alphane-ai/welded-modular-chassis-cad/research/README.md

# 研究记录的范围

本目录保存当前名义尺寸、2026-11-05审核待办及槽24修订核验摘录。原始CAD与PDF只放在生产目录；这里不复制一套旧模型。

| 文件 | 含义 |
| --- | --- |
| [dimensions-current.json](dimensions-current.json) | 当前槽24及箱体、侧板、后孔的名义尺寸汇总 |
| [audit-findings.json](audit-findings.json) | 18项历史审核问题，含后续槽24修订说明；不表示已全部解决 |
| [evidence/slot24-verification.log](evidence/slot24-verification.log) | 历史SOLIDWORKS修订、干涉、保存和重开结果摘录 |

2026-11-07本次上传重新核对的是15个交付文件的数量、内容哈希及仓库资料。没有重新运行全部CAD检查，没有执行实物试制。

图纸原说明及日志中的旧日期、旧侧盖板名称、方案图“尚未修改”等文字保留其记录语境。当前采用的槽宽为24 mm，侧板前卡耳槽仍为18 × 5 mm，背板2 × 24 mm避让保留。

日志只摘录核验结果，去掉电脑绝对路径，并合并重复的相同行；不上传账号凭据、对话原文、临时备份和非生产历史文件。
