alphane-ai/welded-modular-chassis-cad/docs/dimensions-and-interfaces.md

# 名义尺寸与接口

下表汇总当前焊接版的名义值，用于理解设计和检查关联修改。制造尺寸、公差和局部轮廓应同时查阅CAD及工程图。历史审核发现的图模差异见[制造与核验状态](manufacturing-and-verification.md)。

## 坐标与箱体尺寸

模型以X表示箱体宽向，Y表示高度，Z表示前后方向：X0为箱体左侧基准位置，Y0为底面，后外面Z0，前外面Z=-308。侧板孔阵列另以U从前端起算。

| 项目 | 数值 mm | 范围与解释 |
| --- | --- | --- |
| 箱体基体长×宽×高 | 308 × 71.2 × 189 | 不含外伸件 |
| 板厚名义值 | 1.2 | 厚度验收与一般±0.5存在待澄清项 |
| 内部下 / 上平面 | Y1.2 / Y187.8 | 平板内部净高186.6 |
| 回折处最小内部净高 | 184.2 | 按现有说明及历史核验 |
| 四条回折宽 / 有效长 | 8 / 278 | 工艺展开需试折确认 |
| 含侧板基体宽 | 72.4 | 71.2 + 1.2，不含外伸安装件 |
| 含侧板全部已建零件包络 | 长319.3 × 宽84.9 × 高189 | 历史核验；含外伸件，不含未建螺钉 |
| 相同双箱相对平移 | X71.2 | 使用同一套单箱零件 |

## 前插榫槽24修订

| 特征 | 下片 | 上片 |
| --- | ---: | ---: |
| 片中心Y | 50.5 | 138.5 |
| 宽头下边Y | 34.5 | 122.5 |
| 宽头上边Y | 66.5 | 154.5 |
| 槽下边Y | 38.5 | 126.5 |
| 槽上边Y | 62.5 | 150.5 |
| 窄舌下边Y | 42.5 | 130.5 |
| 窄舌上边Y | 58.5 | 146.5 |

| 共用尺寸 | 数值 mm |
| --- | ---: |
| 头宽 / 槽宽 / 上下边栏各 | 32 / 24 / 4 |
| 舌宽 / 舌端上下角半径 | 16 / R2 |
| 槽短边名义值 | 4.5 |
| 头宽净距 / 窄舌净距 / 槽净距 | 56 / 72 / 64 |
| 头部到上下内部平面各 | 33.3 |
| 窄舌到上下内部平面各 | 41.3 |
| 槽到上下内部平面各 | 37.3 |
| 上下片中心距 | 88 |
| 每片点焊X坐标 / 同排点距 | 18、47 / 29 |

两条竖向尺寸链应满足：

```text
宽头：33.3 + 32 + 56 + 32 + 33.3 = 186.6
槽口：37.3 + 24 + 64 + 24 + 37.3 = 186.6
片内：4 + 24 + 4 = 32
```

焊接版前插榫与前面板的原安装铆孔取消为加工孔，相关草图以构造几何或抑制特征保留。不要把点焊定位十字当成钻孔。

## 后部组合孔与挡片

| 项目 | 当前值 |
| --- | --- |
| 后挡片外形 | 24.5 × 8 × 1.2 mm |
| 螺纹 | M3×0.5-6H，模型底孔Ø2.5 |
| 挡片外伸孔X / 背板孔X | -6 / 65.2 mm |
| 下孔Y / 上孔Y / 中心距 | 20.5 / 163.5 / 143 mm |
| 孔至接缝或侧板内贴合面 | 6 mm |
| 每片两段焊缝 | X3～11，每段长8 mm |
| 下挡片焊缝Y / 上挡片焊缝Y | 16.5、24.5 / 159.5、167.5 mm |

M3接口两层均带螺纹的方案按用户要求保留。独立攻丝相位、夹紧方式、螺钉长度与扭矩尚需确认。

## 侧板与前后安装接口

| 项目 | 当前名义值 |
| --- | --- |
| 覆盖外形 / 名义板厚 | 308 × 189 / 1.2 mm |
| 前卡耳数量 / 槽 / 外高 / 内伸 | 2 / 18 × 5 / 26 / 12 mm |
| 前卡槽中心Y | 50.5、138.5 mm |
| 前18槽配16舌的居中余量 | 上下各1 mm，未计极限公差与涂层 |
| 后一体耳数量 / 折弯角 | 2 / 90° |
| 后耳内R / 外R / 耳高 / 平段 | 1.2 / 2.4 / 20 / 10.8 mm |
| 后耳两侧释放槽宽 | 1.2 mm |
| 后耳M3孔 | X65.2，Y20.5、163.5 mm |
| 侧盖内贴合面 | X71.2 mm；双箱最外侧X142.4 mm |
| 背板局部避让 | X69.2～71.2；Y8.5～32.5和151.5～175.5 mm |
| 避让缺口 | 两处2 × 24 mm，内角R0.5，直段23 mm |

侧盖三个外角随箱体R1.7，后下角保留原直角。周边名义贴合不等于已经定义成品最大允许缝隙。

## 侧板X形压印与网孔

| 项目 | 当前值 |
| --- | --- |
| 压印方向 / 深度 | 向箱内 / 1 mm，交叉中心同深1 mm |
| 名义根部宽 / 冠部宽 | 12 / 6 mm |
| 过渡圆角 / 端头 | R2 / R6 |
| 斜筋中心端点1 | (U30,Y26) 到 (U278,Y163) |
| 斜筋中心端点2 | (U30,Y163) 到 (U278,Y26) |
| 无孔横带 | Y84～105，宽21 mm，中线Y94.5 |
| 侧板网孔 | 1522个Ø2，上下各761，节距4 × 4 mm |
| 网孔避让规则 | 孔心到任一斜筋有限中心线段距离小于10 mm的孔取消 |
| 历史记录的筋边到孔边最小名义净距 | 约2.69 mm，考虑R2过渡 |
| 主体上下网孔 | 每面621个Ø2，9列 × 69排，总计1242孔 |
| 主体网孔孔心 | X=19.6+4n，n=0～8；Z=-18-4m，m=0～68 |

所有表中未特别说明的尺寸单位为mm。一般±0.5与未注R0.5沿用用户决定，功能配合、板厚、螺纹及涂后验收的未决事项另行记录，未擅自改成其他公差。
