alphane-ai/welded-modular-chassis-cad/生产图纸 焊接固定/打开与修改说明.md

# 前后安装件焊接版

打开“全焊_相同双箱含侧板_草图可编辑.SLDASM”查看两个相同单体机箱及最外侧盖板装配；侧板前卡槽18配舌宽16、上下各留名义1mm，后耳M3孔同轴、距贴合面6mm，盖板与箱体侧边名义间隙0。已重新打开验证10个组件引用，静态干涉0。也可打开“全焊_相同双箱_草图可编辑.SLDASM”或“全焊_单箱含侧板_草图可编辑.SLDASM”。保留“配套侧板”子目录一起传递。

- 前插榫仍为每片2点电阻点焊、每单箱4点；舌宽16、头宽32、槽24、R2、上下中线Y50.5/138.5；槽上下边栏各4，定位保持原设计。
- 两片后安装挡片改为短段激光搭接焊，上下边各1段长8；各段X3~11，下片Y16.5/24.5，上片Y159.5/167.5。仅焊到本机箱背板，外伸部分及相邻机箱不焊。
- 后挡片24.5x8x1.2保持；原2个Ø2.2铆孔及背板对应4孔取消。挡片M3x0.5-6H保持X=-6，背板组合M3保持X65.2，上下Y20.5/163.5，孔距143。孔距机箱接缝6保持。
- 原后铆孔圆和尺寸改为草图构造几何，仍可编辑；恢复为普通圆后可改回铆接。前安装铆孔仍保留已抑制切除特征。主体30个草图，前插榫7个草图，后挡片2个草图；不是钣金展开工艺树，部分轮廓未全约束。
- 已验证后挡片与背板名义贴合间隙为0、拟定焊缝处下方是实体背板；原组装20纳米显示间隔已移除。
- 单箱、相同双箱、含侧板三套装配重新打开，全部引用本目录，静态实体干涉均0。两个相同单箱相对X平移71.2，两个M3组合孔名义轴线偏差0，侧板后耳M3孔轴对齐。
- 工程图8页，11处原生尺寸无悬空；包含焊缝位置、孔型、公差±0.5、未注R0.5、SPCC t1.2及校平/磨砂/钛灰喷漆要求。逐页渲染检查图文排版。
- 侧板修订X1：308×189×1.2；X形浅压印向箱内深1mm，交叉中心同深1mm，根部名义宽12、冠部宽6、过渡R2、圆头R6。中线Y94.5上下对称，Y84~105保留21mm连续无孔横带。
- 侧板网孔1522个Ø2，方格4×4，上下各761孔；取消孔心至任一斜筋有限中心线段距离小于10的孔。斜筋中心端点为(U30,Y26)-(U278,Y163)、(U30,Y163)-(U278,Y26)，U从前端起算。名义12宽轮廓到孔边至少3，实际R2过渡到孔边最小名义净距约2.69mm。
- 侧盖板15个原生草图；覆盖尺寸、孔径、压印基准面位置、过渡圆角及板厚可在特征树编辑。1522孔共用等径约束；已实测修改孔径、重建、恢复。网孔孔心与压印轮廓尚未完全约束，改变外形或压印尺寸后需复核孔位及避让；不是可直接展开的钣金工艺树。
- 新增“配套侧板/全焊_侧板_X压印深1_尺寸与制造要求.SLDDRW”及同名PDF，7页、46处尺寸无悬空（31处模型关联尺寸、15处二维定位详图尺寸）；涵盖外形、压印、网孔、前后安装件、焊接、公差和表面处理。主体工程图8页已更新背板局部避让，合计15页。
- B1一体侧板总成、单箱含侧板、双箱含侧板分别重建检查，引用全部位于本目录，静态干涉均0。周边贴合面仍为X71.2（双箱全局X142.4），前卡槽和后M3位置保持原设计。
- 焊缝/熔核实体和螺钉未建模，未进行实物承载验证、完整公差叠加或X1侧板的装配路径扫描；名义静态无干涉不代替制造验收。侧板前L卡耳点焊按侧板工程图，同材同厚试焊确认；侧板后M3耳与盖板同料一体折弯，不焊接。
- 激光焊有效焊缝厚度、熔核尺寸、焊接参数必须由加工方同材同厚试焊确认。确保后焊缝熔合至背板、两侧电极可达、无烧穿裂纹；交替短焊、焊后校平，再喷漆并保护M3。
- 原铆接版、螺栓版及前焊后铆版均未覆盖。整理旧窗口时，未保存内容副本在工作目录“前后全焊_核验/未保存窗口副本_…”中。

## B1 侧板后耳一体折弯与边角随形修订

- 侧板后M3安装耳改为盖板同料一体90°折弯，2处；不允许后耳分体焊接。内R1.2、外R2.4，厚1.2，耳高20，平段10.8，M3×0.5-6H，底孔Ø2.5。孔中心X65.2、Y20.5/163.5、中心距143，至侧盖内贴合面X71.2的距离6保持。
- 侧盖板内的原生草图、拉伸、切除、圆角及2处原生螺纹标注保留；是一体连续实体。折弯两侧工艺释放槽宽1.2、至Z−2.4；实际展开、折弯补偿和回弹需同材同厚试折确认。当前仍是可编辑实体特征树，不是自动钣金展开树。
- 用户确认允许背板上下局部避让。背板右缘新增2处2×24缺口，X69.2~71.2；Y8.5~32.5及151.5~175.5，内角R0.5。M3轴线及机箱本体后部焊接组合挡片不变。
- 对照箱体实际折弯轮廓，侧盖板前上、前下、后上三角随箱体外R1.7；箱体对应内圆角R0.5。后下角按原箱体直角保留。覆盖包络308×189保持。
- 侧板总成只含一体盖板1件及前L卡耳2件；原分体后耳已移出生产目录备份。侧板、单箱含侧板、相同双箱含侧板分别为3、10、17个递归组件节点；重建后静态干涉0。
- 单箱含侧板三维装配的“注解”树保存M01外形、M02后M3及折弯、M03前舌卡槽、M04侧板网孔压印、M05主体顶底网孔、M06后板开口避让六组视图，共27个模型关联参考尺寸；制造仍以工程图标注为准。可在注解树切换视图，防止所有标注同时叠在一起。
- B1主体工程图8页；侧板工程图7页，其中第7页为一体折弯截面与背板避让。原分体后耳焊接说明已移除。保留一般±0.5、M3按6H、未注R0.5，SPCC t1.2，校平/磨砂/钛灰喷漆。

## C1 前插榫槽24修订（2026-11-05）

- 按批准方案，将两片前插榫自身槽净宽由22改为24，每槽上下边各向外扩1，槽中线不变。边栏各由5改为4；两槽净距由66改为64，槽至上下内部平面距离各由38.3改为37.3。
- 上槽Y126.5~150.5；下槽Y38.5~62.5；头宽32、舌宽16、舌端R2、宽头间距56、窄舌间距72、中心距88及焊点保持。侧板前卡耳的18x5槽保持，背板两处2x24折弯避让保持。
- 共用前插榫零件保留7个原生草图；单箱、单箱含侧板、相同双箱、相同双箱含侧板4套装配已更新。实体检查与特征错误均0，4套装配静态干涉均0。
- 主体工程图第6、7页对应槽宽、边栏和名义间隙说明同步为24、4、4，公差继续为±0.5。其余历史审核事项不因本次槽宽修订自动视为解决。
