alphane-ai/welded-modular-chassis-cad/生产图纸 焊接固定/全焊_单箱_草图可编辑.SLDASM

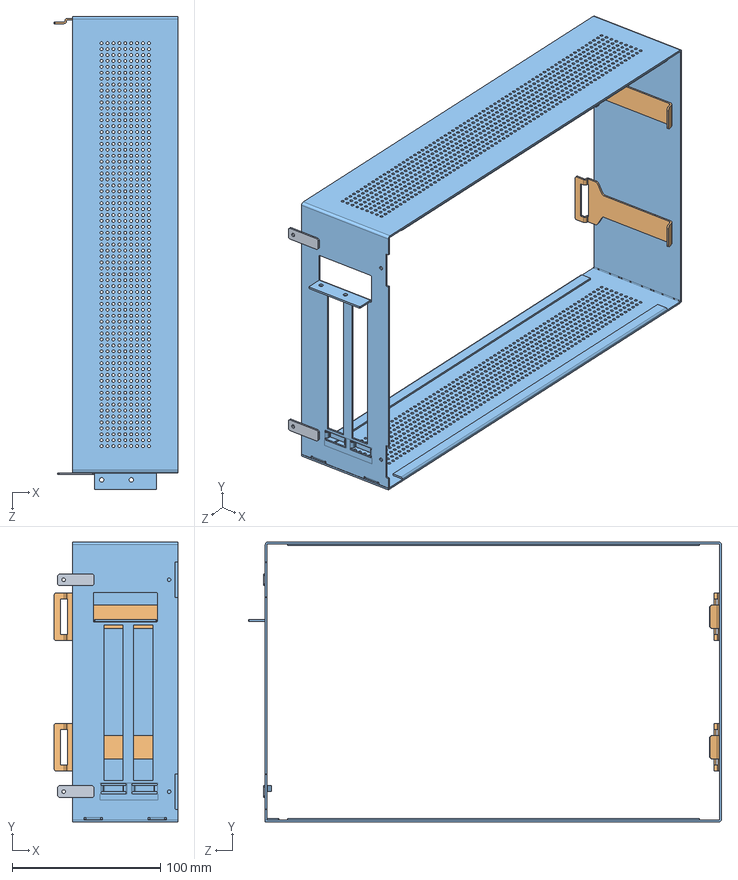
[picture p4: CAD file, 2026-11-07]
生产图纸 焊接固定/全焊_单箱_草图可编辑.SLDASM
83.7 x 189.0 x 319.3 mm
全焊_主体_草图可编辑
全焊_前插榫_舌16_R2_草图可编辑 x 2
全焊_后安装挡片_M3_草图可编辑 x 2
