alphane-ai/welded-modular-chassis-cad/生产图纸 焊接固定/配套侧板/全焊_侧板总成_草图可编辑.SLDASM

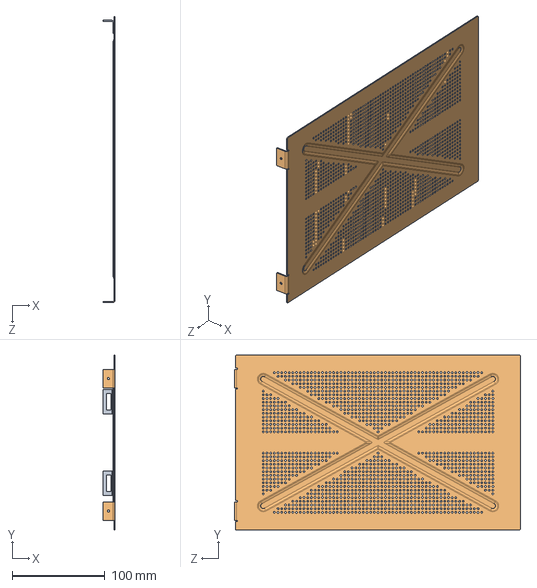
[picture p5: CAD file, 2026-11-07]
生产图纸 焊接固定/配套侧板/全焊_侧板总成_草图可编辑.SLDASM
13.2 x 189.0 x 309.2 mm
全焊配套_侧盖板_草图可编辑
全焊配套_前卡耳_内伸12_槽18乘5_草图可编辑 x 2
