alphane-ai/welded-modular-chassis-cad/生产图纸 焊接固定/全焊_单箱含侧板_草图可编辑.SLDASM

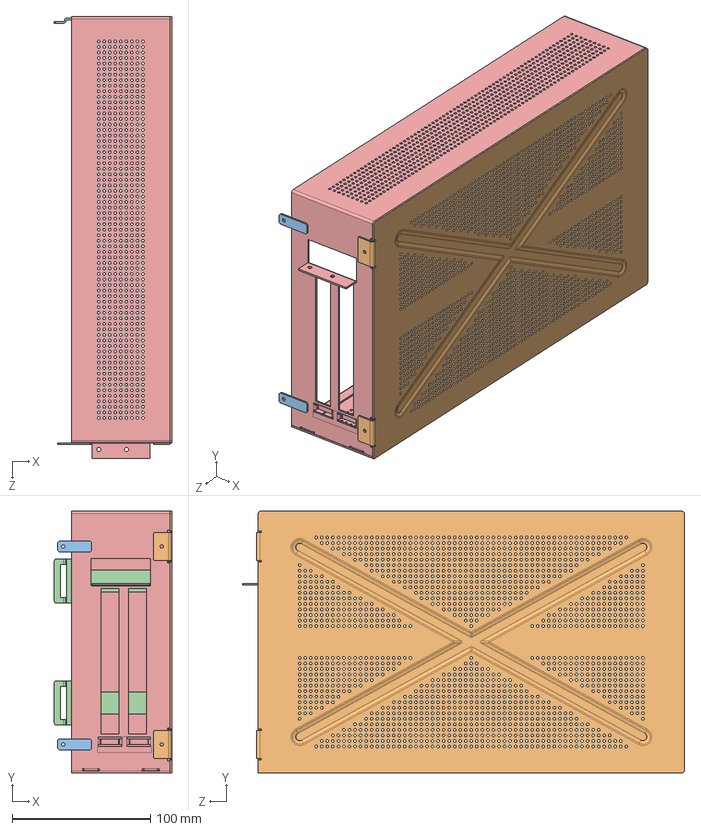
[picture p6: CAD file, 2026-11-07]
生产图纸 焊接固定/全焊_单箱含侧板_草图可编辑.SLDASM
84.9 x 189.0 x 319.3 mm
全焊_主体_草图可编辑
全焊_前插榫_舌16_R2_草图可编辑 x 2
全焊_后安装挡片_M3_草图可编辑 x 2
全焊配套_侧盖板_草图可编辑
全焊配套_前卡耳_内伸12_槽18乘5_草图可编辑 x 2
