alphane-ai/welded-modular-chassis-cad/生产图纸 焊接固定/全焊_主体_草图可编辑.SLDPRT

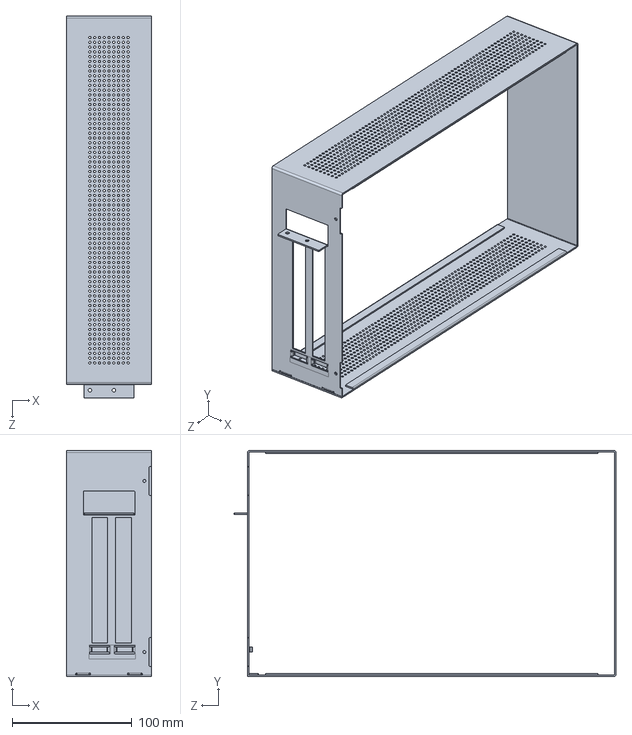
[picture p8: CAD file, 2026-11-07]
生产图纸 焊接固定/全焊_主体_草图可编辑.SLDPRT
71.2 x 189.0 x 319.3 mm
