alphane-ai/welded-modular-chassis-cad/生产图纸 焊接固定/配套侧板/全焊配套_前卡耳_内伸12_槽18乘5_草图可编辑.SLDPRT

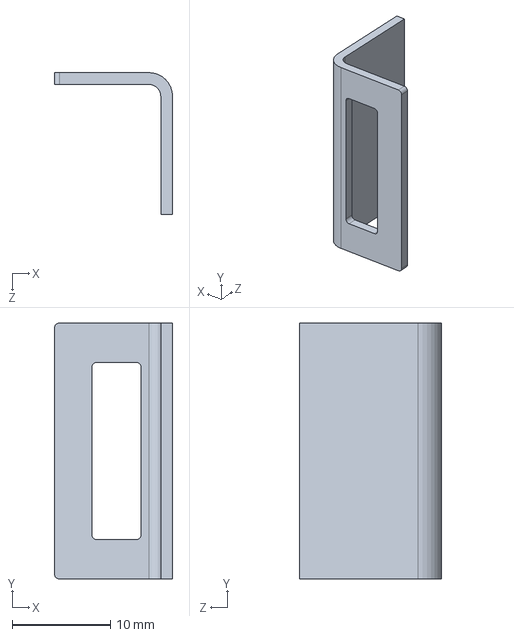
[picture p9: CAD file, 2026-11-07]
生产图纸 焊接固定/配套侧板/全焊配套_前卡耳_内伸12_槽18乘5_草图可编辑.SLDPRT
12.0 x 26.0 x 14.4 mm
