alphane-ai/welded-modular-chassis-cad/生产图纸 焊接固定/全焊_后安装挡片_M3_草图可编辑.SLDPRT

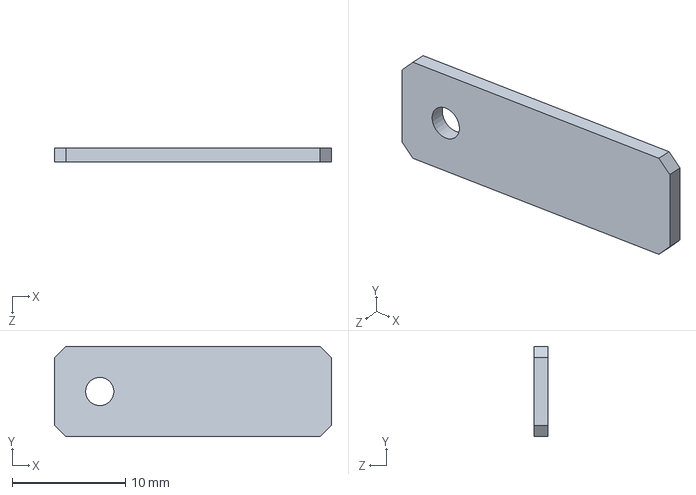
[picture p10: CAD file, 2026-11-07]
生产图纸 焊接固定/全焊_后安装挡片_M3_草图可编辑.SLDPRT
24.5 x 8.00 x 1.20 mm
