alphane-ai/welded-modular-chassis-cad/生产图纸 焊接固定/全焊_前插榫_舌16_R2_草图可编辑.SLDPRT

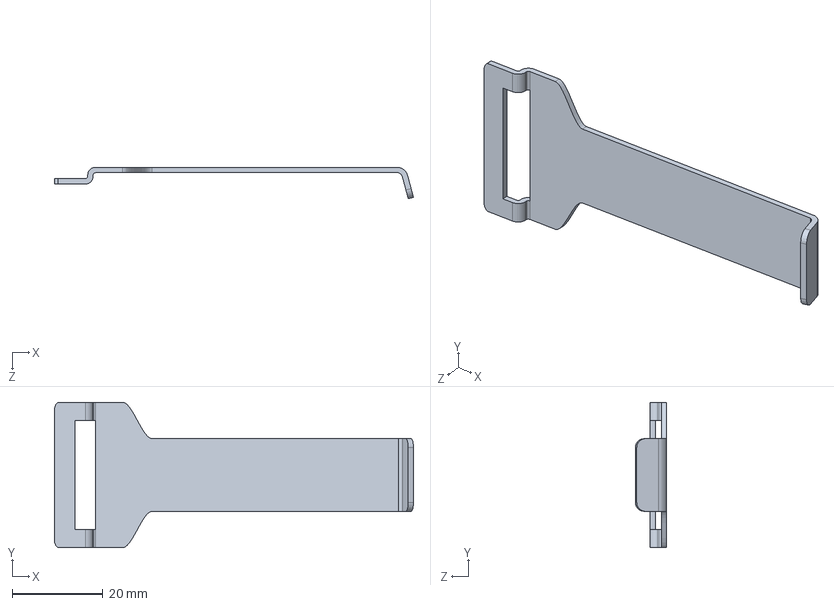
[picture p11: CAD file, 2026-11-07]
生产图纸 焊接固定/全焊_前插榫_舌16_R2_草图可编辑.SLDPRT
79.0 x 32.0 x 6.92 mm
