alphane-ai/welded-modular-chassis-cad/(list of files, cad)

Other CAD files:
生产图纸 焊接固定/全焊_相同双箱含侧板_草图可编辑.SLDASM
生产图纸 焊接固定/配套侧板/全焊配套_侧盖板_草图可编辑.SLDPRT
生产图纸 焊接固定/全焊_生产尺寸与制造要求.SLDDRW
生产图纸 焊接固定/配套侧板/全焊_侧板_X压印深1_尺寸与制造要求.SLDDRW
