alphane-ai/welded-modular-chassis-cad/docs/manufacturing-and-verification.md

# 制造要求与核验状态

## 已有名义制造要求

图纸指定SPCC冷轧钢板，名义厚1.2 mm；表面采用校平（压直）、磨砂、钛灰喷漆。一般尺寸及位置沿用用户确定的±0.5 mm，未注边角R0.5，已注R2等功能圆角保留；M3按M3×0.5-6H。

前插榫与前板采用每片2点电阻点焊；后安装挡片采用每片上下边各1段8 mm激光搭接焊；侧板前L卡耳为独立点焊件，后M3耳为同料一体折弯。焊接参数、有效厚度、熔核尺寸及验收值仍需同材同厚试焊确认。

## 已有核验与边界

| 对象 | 记录中的结果 | 适用范围 |
| --- | --- | --- |
| 槽24前插榫 | 单连续实体、实体与特征检查0错误、保留7张原生草图 | 2026-11-05槽24修订 |
| 槽边修改 | 只切除上下新增槽边带，总去除约14.5338 mm³ | 外包络、舌16、头32、R2和对称关系保持 |
| 四套相关装配 | 单箱、单箱含侧板、双箱、双箱含侧板静态干涉均0 | 名义静态实体；未含实际焊缝和螺钉 |
| 保存后重开 | 10个三维文档的引用可解析，槽24及草图保留 | 当时本地目录的保存验证 |
| 主体工程图 | 8页、11处尺寸无悬空；第6、7页槽24文字已同步 | 关联尺寸与对应说明 |
| 侧板工程图 | 7页、46处尺寸；历史审核记录无悬空 | 其中15处二维示意覆写，非全部模型关联 |
| 当前上传文件 | 15文件逐一匹配最终整理SHA-256，无内容重复 | 文件完整性；不替代CAD或实物检查 |

静态干涉为0，不能替代最不利公差、装入/拆出运动、涂后间隙、焊接变形和连接承载验证。

## 历史审核待办

2026-11-05审核记录18项问题。以下为归档时的状态，除明确说明的槽24相关修订外，未把它们自动判为解决。本次没有为上传而更改几何、公差或加工工艺。

| 编号 | 核心问题 | 后续核对方向 |
| --- | --- | --- |
| F01 | 板厚1.20±0.50与按采购板厚验收的文字冲突 | 单列板厚与采购公差，避免一般公差误套 |
| F02 | 背板两条13×105槽的R0.5说明与实体直角不一致 | 确认圆角要求并同步图模 |
| F03 | 后板下部清线开口的矩形文字描述与实体轮廓不同 | 补局部详图、真实切边和连接桥标注 |
| F04 | 缺可验收展开、DXF/DWG下料和折弯补偿资料 | 建立钣金展开工艺或经验证的加工展开 |
| F05 | 底部Ø2.2孔、底舌和上窗托边孔的定位不充分 | 补底视、剖面、孔型、孔位及用途 |
| F06 | 基体308×71.2×189未包含所有凸出件 | 区分基体与整机包络；历史包络319.3×84.9×189 |
| F07 | 侧板18槽与16舌在统一±0.5下不能保证极限装配 | 共同功能基准、涂后最小余量和位置公差；前片槽改24不解决这组18槽配合 |
| F08 | 保留背板2×24缺口后，折弯耳与缺口的极限余量待核对 | 缺口保留；核对公差、圆角与喷涂后的最小间隙 |
| F09 | 名义侧缝0未定义成品允许缝隙和平整度 | 补覆盖、翘曲、边缘缝和涂后验收方法 |
| F10 | 对应两层均M3，攻丝相位、夹紧和薄板承载待定 | 保持M3要求，确认攻丝顺序、螺钉及扭矩等 |
| F11 | 文字坐标尚未形成统一图形基准和形位要求 | 标基准面/边与可测的折弯、平面度、位置要求 |
| F12 | 局部轮廓、折弯链和焊接验收仍不充分 | 补详图与剖面，把试焊结果转成验收指标 |
| F13 | 历史审核56个草图欠约束，组件采用固定坐标 | 补驱动尺寸、对称关系和关键装配配合 |
| F14 | 侧板15处二维覆写尺寸不自动跟随三维 | 改成关联尺寸或明确参数及人工复核步骤 |
| F15 | 上下避让标注名颠倒、其他参考尺寸与说明数量待整理 | 对照当前文件复核名称、视图和数量，不能沿用旧数值结论 |
| F16 | 材料实体属性、图号、版次和模板信息未收口 | 统一实际材质和属性；未赋材前不采用模型质量作为实重 |
| F17 | 小尺寸在整板比例下不易检验 | 补局部放大、中心线、引线和特征编号 |
| F18 | 运动、公差、喷涂和实物试装未闭环 | 装入路径、极限试配、焊接与涂后首件验证 |

[结构化审核待办](../research/audit-findings.json)保留原问题的位置、证据和建议；它是历史审核记录。前片槽22已改24、边栏5已改4，早期数字不应重新写回当前模型。F15涉及的临时参考尺寸数值也需以现有文件核对。

## 18槽配16舌的公差示例

这组接口是侧板前卡耳槽，不是此次扩大为24的前片自身槽：

```text
名义单侧余量 = (18 - 16) / 2 = 1 mm
槽最小17.5、舌最大16.5时，居中单侧余量 = 0.5 mm
槽、舌中心分别±0.5时，相对错位最多可达1 mm
简化极限组合可出现单侧0.5 mm侵入，尚未计涂层
```

这是审核中的尺寸链风险示例，没有声称实物已经发生干涉。通用±0.5暂沿用用户决定，未用仓库上传动作改变设计。

## 制造放行前建议完成

1. 统一CAD、工程图、局部坐标文字、基准、材料和版次。
2. 确认下料展开、折弯/压印工艺、回弹与焊接参数。
3. 对前后功能接口完成极限公差及喷涂后间隙核对。
4. 进行侧板装入和拆出路径检查，以及M3和焊接承载试验。
5. 首件制造后验收外形、盖合、平整度、孔槽、螺纹与拆装，再确定生产放行状态。

目前未建立完整自动钣金展开，也没有提交虚构的强度、材料或实物试验结果。
