alphane-ai/welded-modular-chassis-cad/docs/revision-history.md

# 修订与证据时间线

仓库初始提交整理于2026-11-07。以下日期来自已经保存的设计和核验记录；此次上传没有重新运行实体干涉、材料试验或制造放行审核。

| 阶段 | 已采用的结果 | 当前状态 |
| --- | --- | --- |
| 早期孔位及版本研究 | 保留背板6 mm边距；M3与原铆孔的用途分别讨论 | 仅最终焊接版归档 |
| 前插榫对称设计 | 头宽32、舌宽16、舌端R2、中线Y50.5 / 138.5；撤回下片向下1 mm方案 | 当前设计保持 |
| 2026-11-04前后安装件焊接版 | 前片每片2点电阻点焊，后挡片每片两段8 mm激光焊 | 已保存模型与工程图 |
| 2026-11-04侧板X1 | 覆盖308×189，X形压印深1，Ø2网孔及21 mm无孔横带 | 当前侧板形式 |
| 2026-11-04侧板B1 | 后M3耳同料一体折弯、背板两处2×24避让、边角随形 | 保留 |
| 2026-11-05审核 | 记录18项图模差异、资料缺项及待验证事项 | 未因归档或上传自动关闭 |
| 2026-11-05槽24修订C1 | 前片自身长槽22→24，上下各扩1，边栏5→4，中心不动 | 单件和四套相关装配已保存 |
| 2026-11-05槽24工程图同步 | 主体工程图第6、7页槽24、边栏4、居中余量4；11处尺寸无悬空 | PDF已同步 |
| 2026-11-05最终目录整理 | 生产目录15文件、无内容重复；重复ZIP移除；侧盖板采用简化后的当前文件名 | 本次上传逐文件匹配整理清单 |
| 2026-11-07仓库整理 | 公开仓库、项目介绍、尺寸与决策说明、历史核验边界、文件完整性工具 | 上传工作；不修改CAD几何 |

## 槽24修订证据

[历史日志摘录](../research/evidence/slot24-verification.log)取自当时修订、保存和重开记录，保留相关核验结果。日志中的侧盖板名称可能带有早期的`贴合无2mm缝`描述，最终生产目录已使用`全焊配套_侧盖板_草图可编辑.SLDPRT`。仓库以清单中的文件名为准。

源记录显示槽24修订只去除原槽上下两条材料带，总去除体积约14.5338 mm³；外包络、头宽32、舌宽16、两处R2及对称关系不变。四套相关装配静态干涉均为0，重开后全部引用可解析，前插榫保留7张原生草图。

这些是历史实测结果，不是对2026-11-07重新开展CAD检查的声明。本次上传只重新核验最终15文件与整理清单的哈希、文件数量和仓库内容。
