alphane-ai/welded-modular-chassis-cad/生产图纸 焊接固定/全焊_生产尺寸与制造要求.pdf

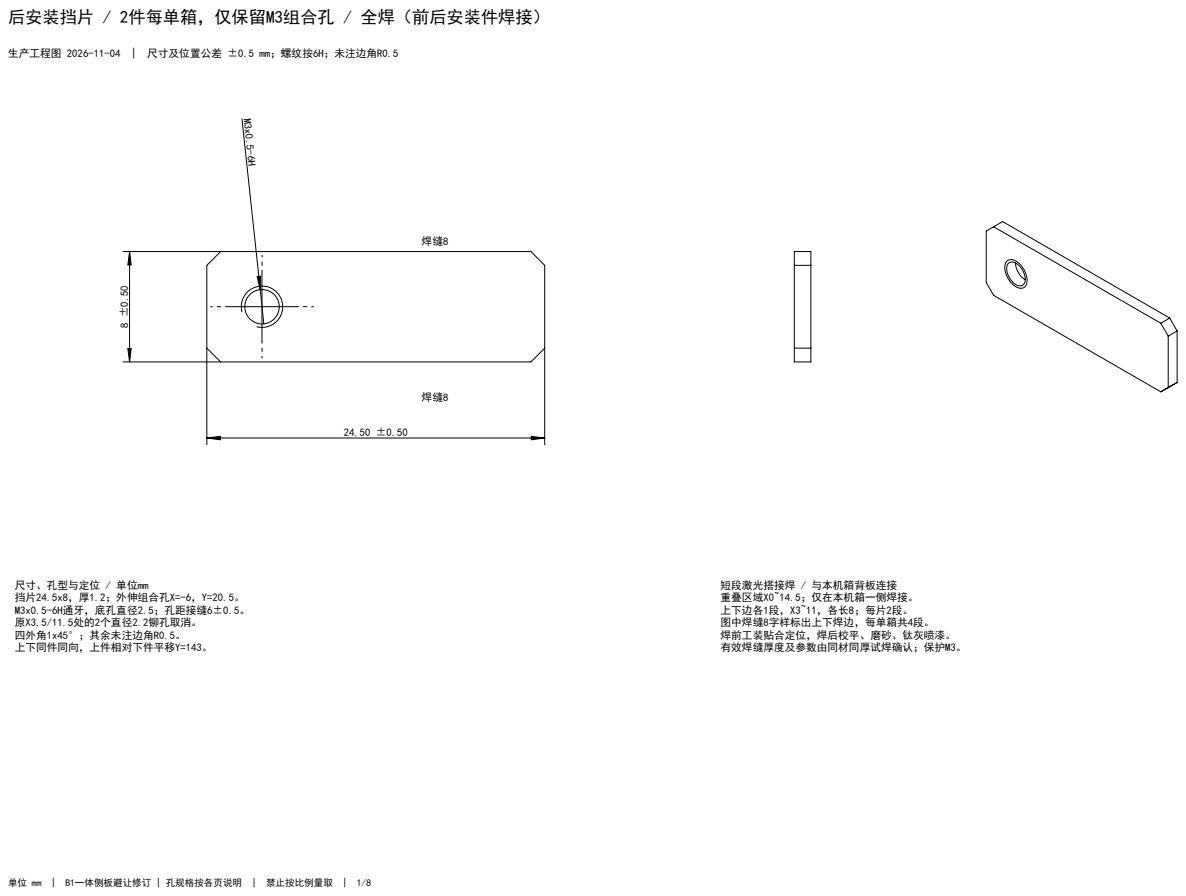
[picture p12: page 1]
尺寸、孔型与定位 / 单位mm; 短段激光搭接焊 / 与本机箱背板连接

后安装挡片 / 2件每单箱，仅保留M3组合孔 / 全焊（前后安装件焊接）

生产工程图 2026-11-04 | 尺寸及位置公差 ±0.5 mm；螺纹按6H；未注边角R0.5

单位 mm | B1一体侧板避让修订 | 孔规格按各页说明 | 禁止按比例量取 | 1/8

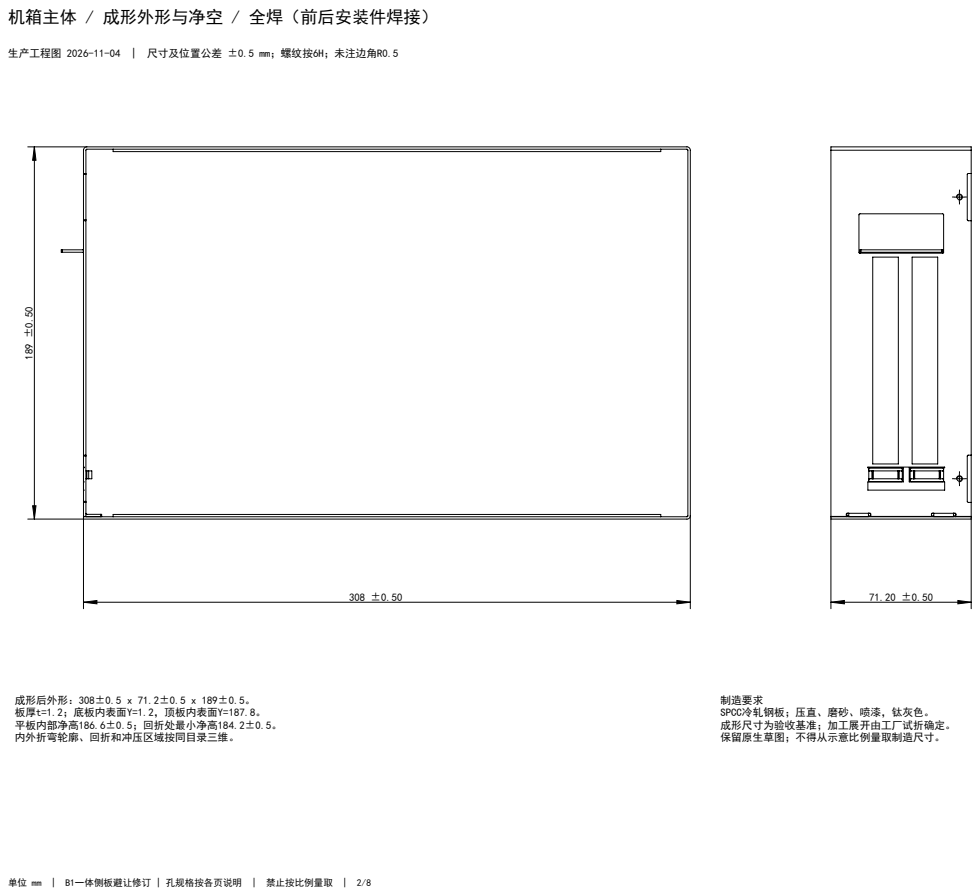
[picture p13: page 2]

机箱主体 / 成形外形与净空 / 全焊（前后安装件焊接）

生产工程图 2026-11-04 | 尺寸及位置公差 ±0.5 mm；螺纹按6H；未注边角R0.5

成形后外形：308±0.5 x 71.2±0.5 x 189±0.5。
板厚t=1.2；底板内表面Y=1.2，顶板内表面Y=187.8。
平板内部净高186.6±0.5；回折处最小净高184.2±0.5。
内外折弯轮廓、回折和冲压区域按同目录三维。

制造要求
SPCC冷轧钢板；压直、磨砂、喷漆，钛灰色。
成形尺寸为验收基准；加工展开由工厂试折确定。
保留原生草图；不得从示意比例量取制造尺寸。

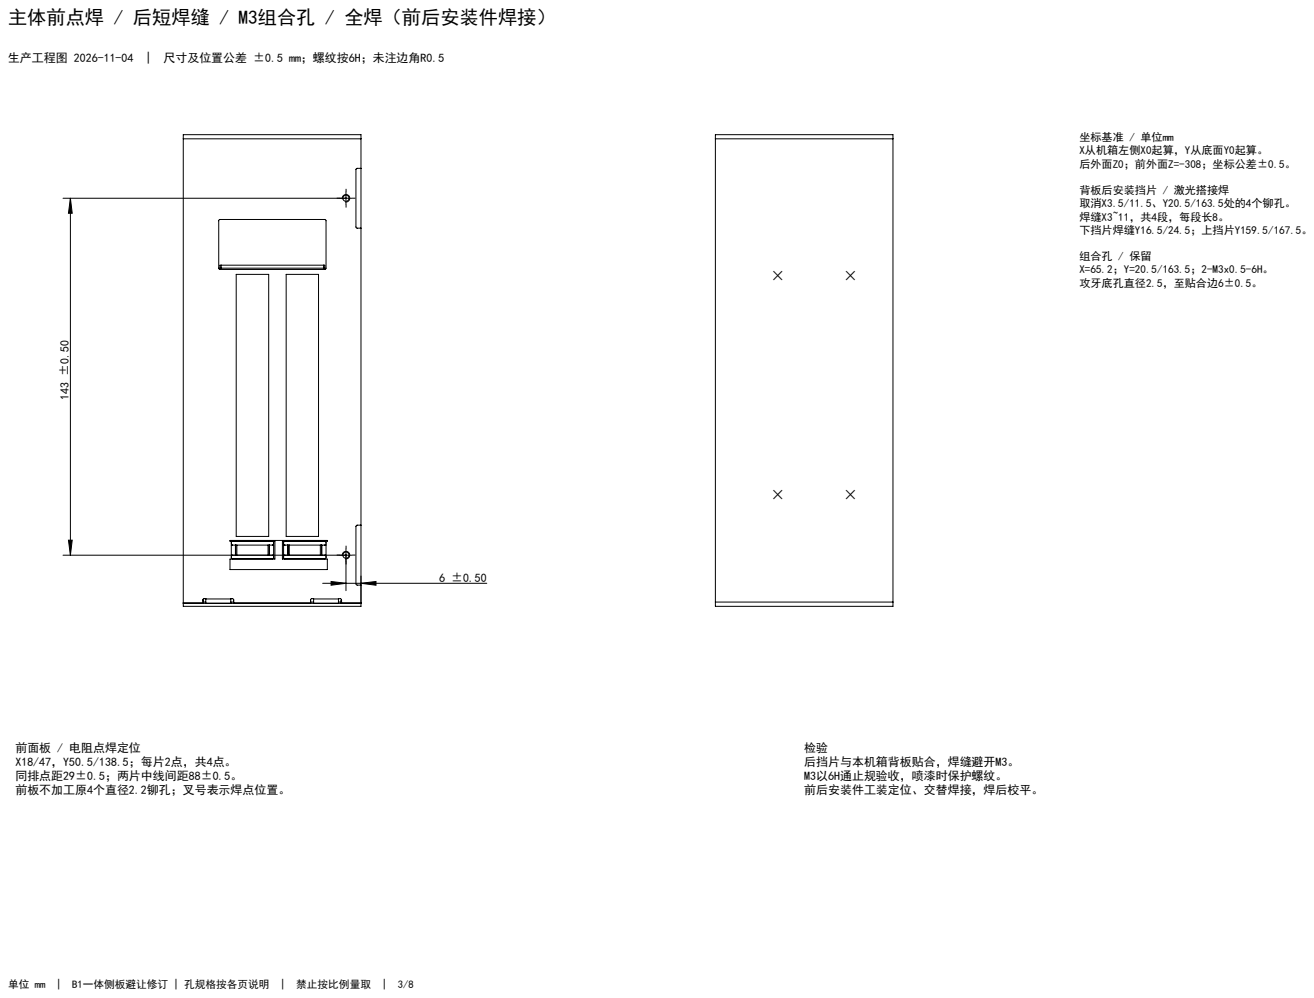
[picture p14: page 3]
坐标基准 / 单位mm; 背板后安装挡片 / 激光搭接焊; 组合孔 / 保留; 前面板 / 电阻点焊定位

主体前点焊 / 后短焊缝 / M3组合孔 / 全焊（前后安装件焊接）

生产工程图 2026-11-04 | 尺寸及位置公差 ±0.5 mm；螺纹按6H；未注边角R0.5

后挡片与本机箱背板贴合，焊缝避开M3。
M3以6H通止规验收，喷漆时保护螺纹。
前后安装件工装定位、交替焊接，焊后校平。

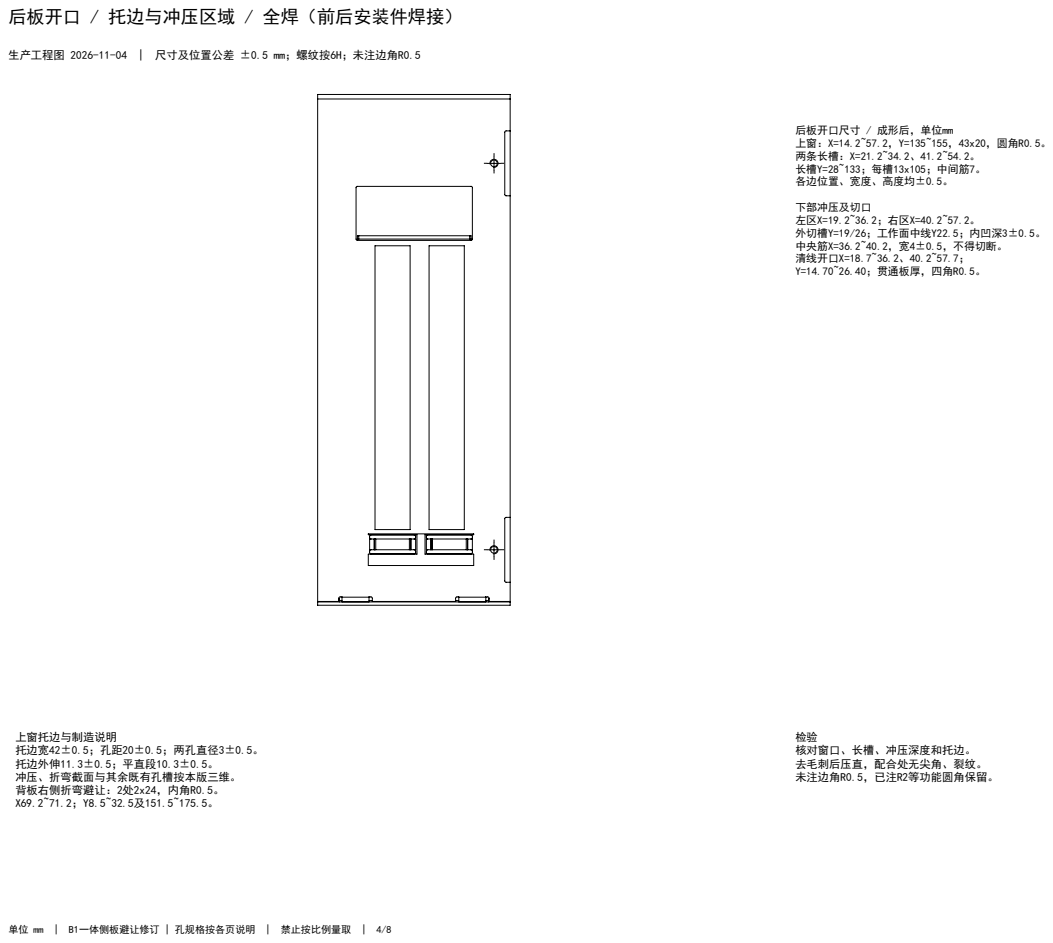
[picture p15: page 4]

后板开口 / 托边与冲压区域 / 全焊（前后安装件焊接）

生产工程图 2026-11-04 | 尺寸及位置公差 ±0.5 mm；螺纹按6H；未注边角R0.5

后板开口尺寸 / 成形后，单位mm
上窗：X=14.2~57.2，Y=135~155，43x20，圆角R0.5。
两条长槽：X=21.2~34.2、41.2~54.2。
长槽Y=28~133；每槽13x105；中间筋7。
各边位置、宽度、高度均±0.5。

核对窗口、长槽、冲压深度和托边。
去毛刺后压直，配合处无尖角、裂纹。
未注边角R0.5，已注R2等功能圆角保留。

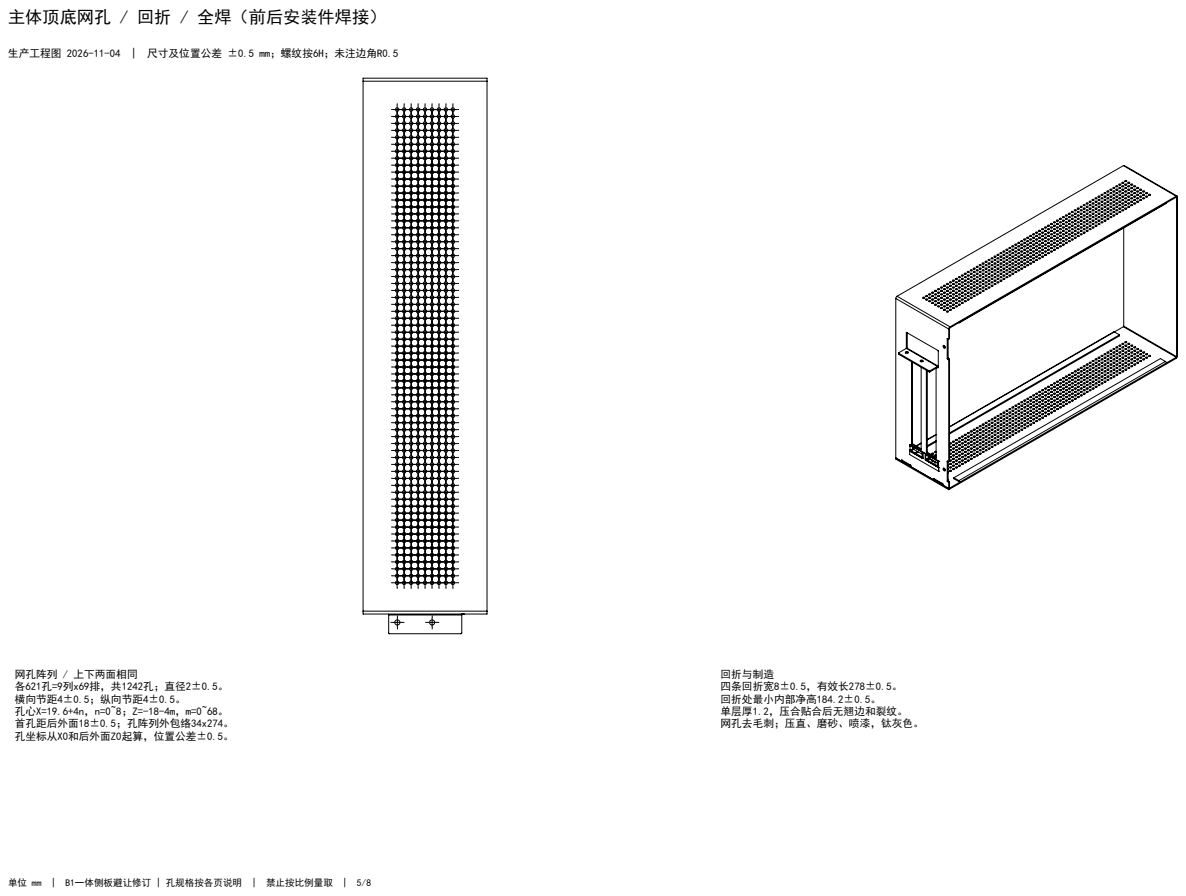
[picture p16: page 5]
网孔阵列 / 上下两面相同

主体顶底网孔 / 回折 / 全焊（前后安装件焊接）

生产工程图 2026-11-04 | 尺寸及位置公差 ±0.5 mm；螺纹按6H；未注边角R0.5

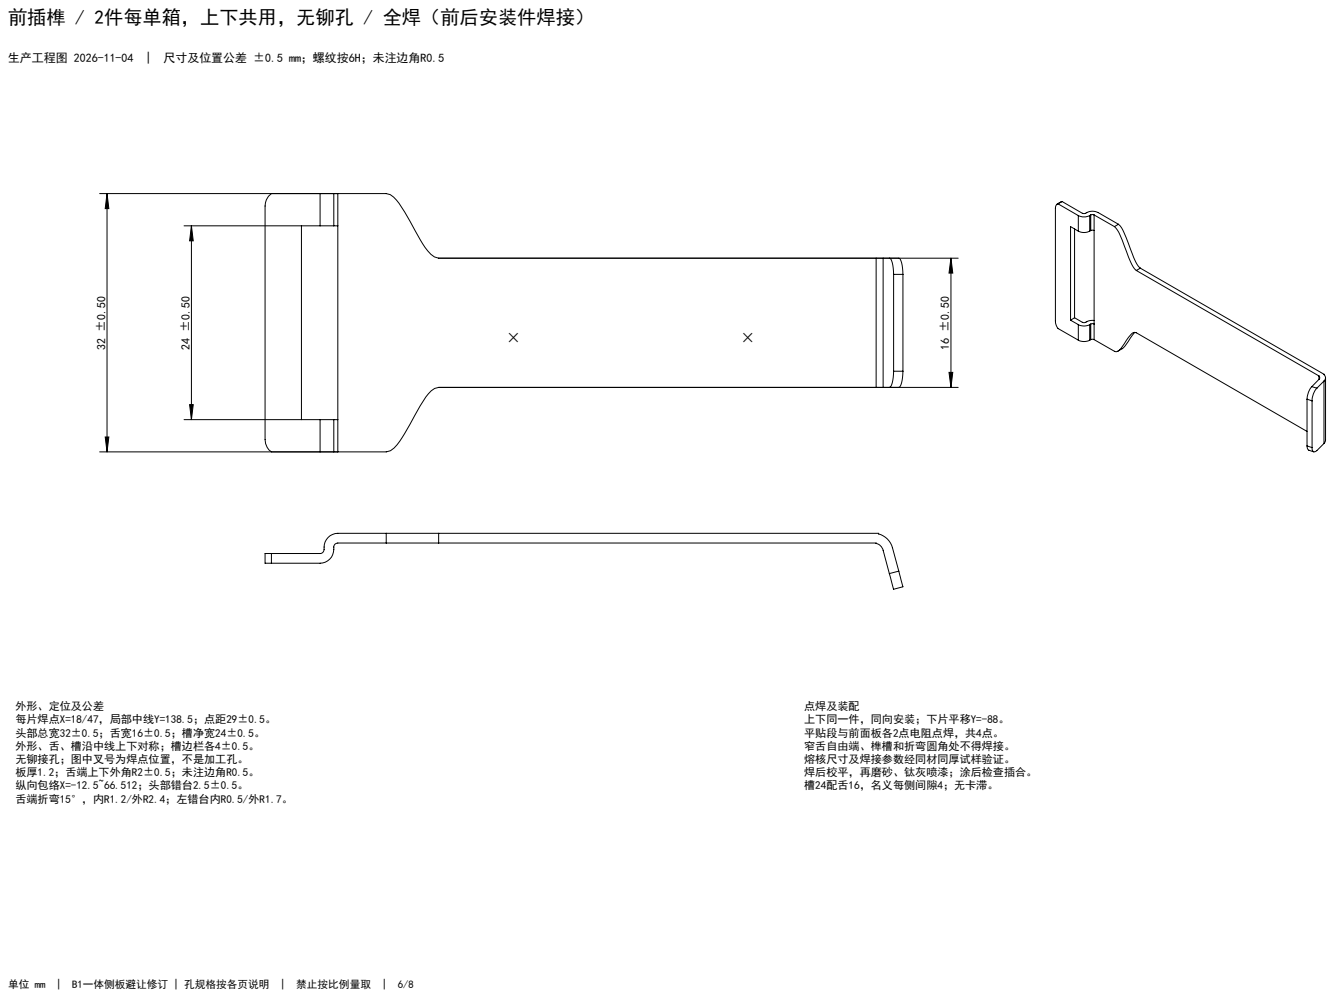
[picture p17: page 6]

前插榫 / 2件每单箱，上下共用，无铆孔 / 全焊（前后安装件焊接）

生产工程图 2026-11-04 | 尺寸及位置公差 ±0.5 mm；螺纹按6H；未注边角R0.5

点焊及装配
上下同一件，同向安装；下片平移Y=-88。
平贴段与前面板各2点电阻点焊，共4点。
窄舌自由端、榫槽和折弯圆角处不得焊接。
熔核尺寸及焊接参数经同材同厚试样验证。
焊后校平，再磨砂、钛灰喷漆；涂后检查插合。
槽24配舌16，名义每侧间隙4；无卡滞。

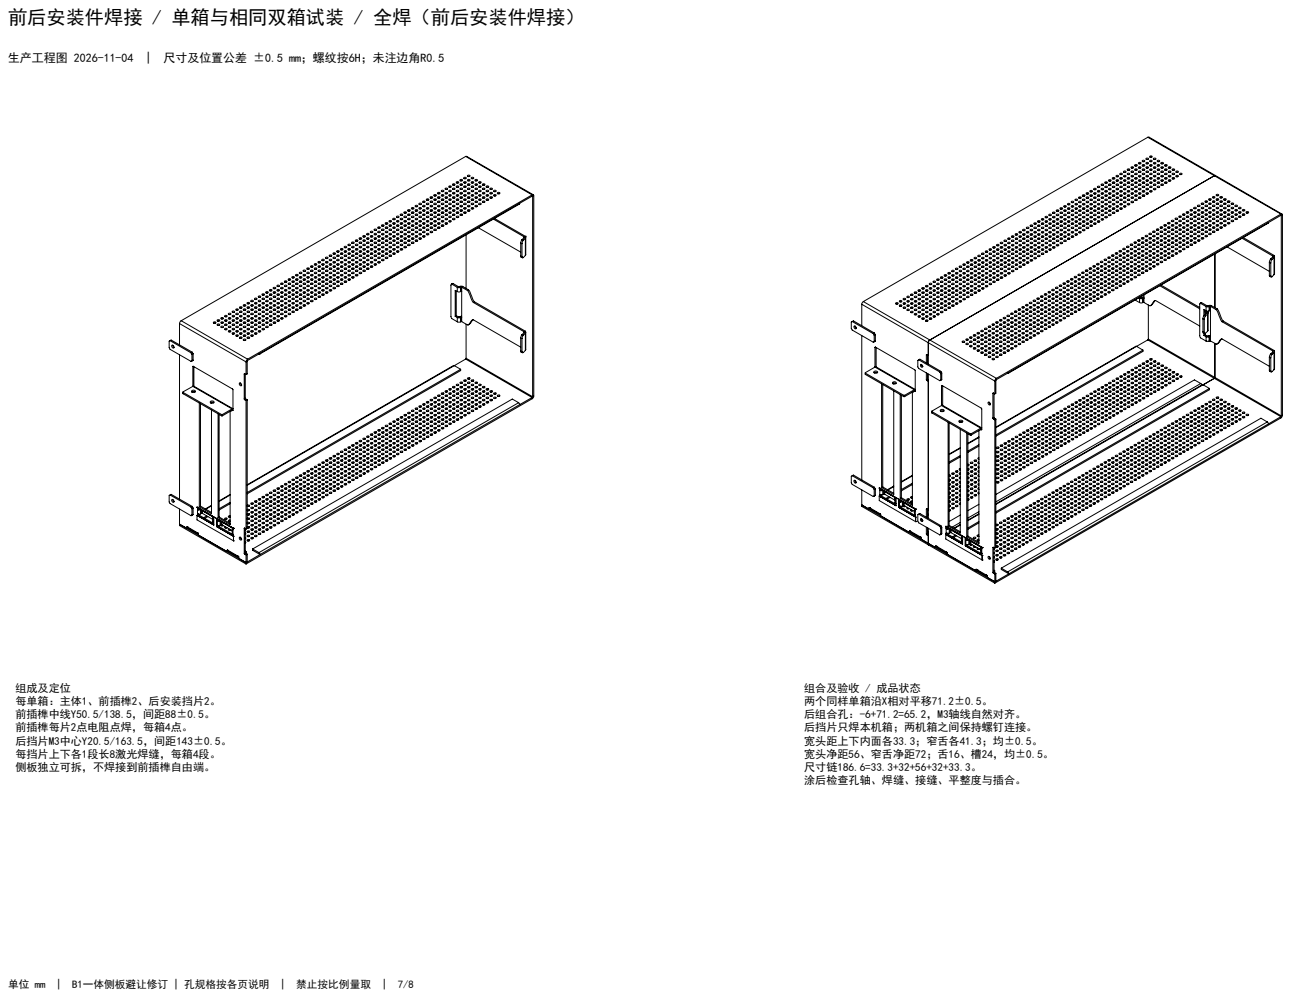
[picture p18: page 7]
组合及验收 / 成品状态

前后安装件焊接 / 单箱与相同双箱试装 / 全焊（前后安装件焊接）

生产工程图 2026-11-04 | 尺寸及位置公差 ±0.5 mm；螺纹按6H；未注边角R0.5

## 材料 / 前点焊及后短焊缝 / 公差与检验 / 全焊（前后安装件焊接）

生产工程图 2026-11-04 | 尺寸及位置公差 ±0.5 mm；螺纹按6H；未注边角R0.5

材料与表面处理
SPCC冷轧钢板，JIS G3141，名义板厚t=1.2mm。 前插榫、后挡片与主体采用配套钢材。
成形去毛刺 → 清洁 → 工装定位焊接 → 校平 → 磨砂 → 喷漆。 颜色钛灰色，参考HEX #666666，以实物色板控制。 漆面均匀，无露底、流挂及明显压痕、划伤、色差。
喷涂时保护M3螺纹，配合处不得积漆。

尺寸及边角
未另注尺寸、孔中心及焊接位置公差：±0.5mm。
M3按M3x0.5-6H验收，不套用±0.5线性公差。 未注边角R0.5；已注1x45°、舌端R2保留。
板厚按采购标准；折弯及错台按三维名义轮廓。
取消前板4孔、两片前插榫各2孔、背板4孔、
两片后挡片各2孔，合计16个原铆孔板层孔。
原孔草图留作构造几何/抑制特征，可手动恢复。

焊接要求
前插榫：每片2点电阻点焊，共4点，见第3、6页。
后挡片：上下边各一段8mm激光搭接焊，共4段，见第1、3页。 后挡片X3~11焊缝必须熔合至背板，不允许仅熔挡片边缘。 采用工装贴合定位，前后交替短焊控制变形，焊后校平。
焊前去油、去膜；无涂层，焊后再进行表面处理。
熔核尺寸、有效焊缝厚度及设备参数由同材同厚试焊确认。 实样检查强度、熔合、压痕、烧穿与变形后再生产。
不得漏焊、烧穿、开裂或有影响插合的飞溅。
外伸M3孔与舌片自由端不焊，两机箱保持可拆螺接。

检验及模型说明
检查舌槽、R2、焊点/焊缝位置、M3、板面及涂后插合。 后组合孔自然同轴，M3用6H通止规检查。
模型保留定位草图，未建立熔核及实际焊缝实体。
名义装配无干涉不等同于实物焊接强度及公差验收。

使用：单位mm，禁止按比例量取。主体、安装件及装配以本目录为准；侧板后M3耳一体折弯，背板两处避让按第4页。
