alphane-ai/welded-modular-chassis-cad/生产图纸 焊接固定/配套侧板/全焊_侧板_X压印深1_尺寸与制造要求.pdf

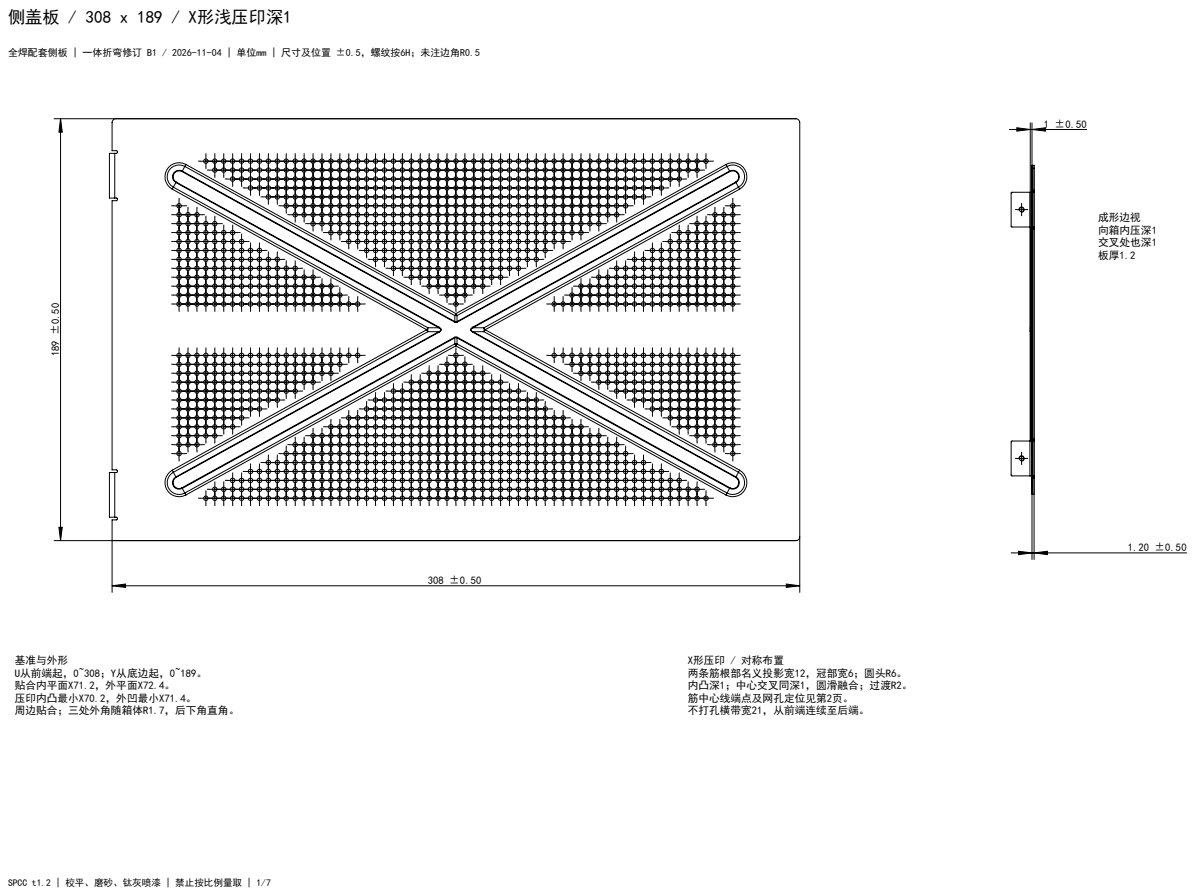
[picture p19: page 1]
侧盖板 / 308 x 189 / X形浅压印深1; X形压印 / 对称布置

全焊配套侧板 | 一体折弯修订 B1 / 2026-11-04 | 单位mm | 尺寸及位置 ±0.5，螺纹按6H；未注边角R0.5

SPCC t1.2 | 校平、磨砂、钛灰喷漆 | 禁止按比例量取 | 1/7

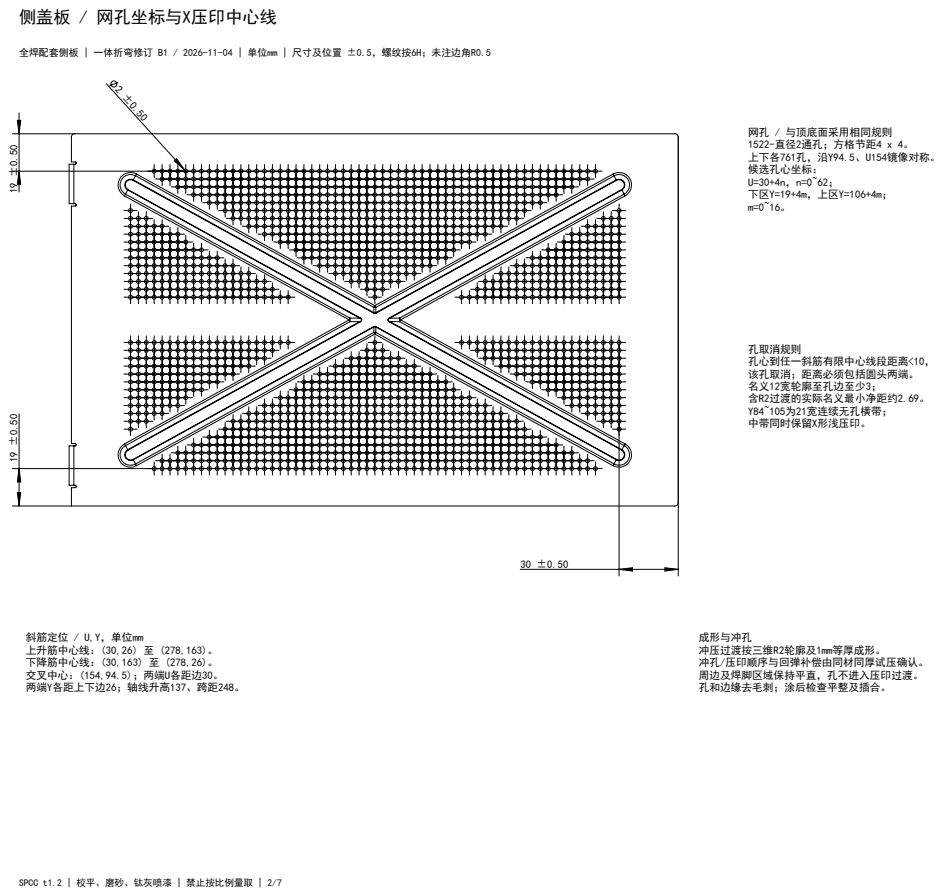
[picture p20: page 2]
侧盖板 / 网孔坐标与X压印中心线; 网孔 / 与顶底面采用相同规则 1522-直径2通孔；方格节距4 x 4。; 斜筋定位 / U,Y，单位mm 上升筋中心线：(30,26) 至 (278,163)。 下降筋中心线：(30,163) 至 (278,26)。

全焊配套侧板 | 一体折弯修订 B1 / 2026-11-04 | 单位mm | 尺寸及位置 ±0.5，螺纹按6H；未注边角R0.5

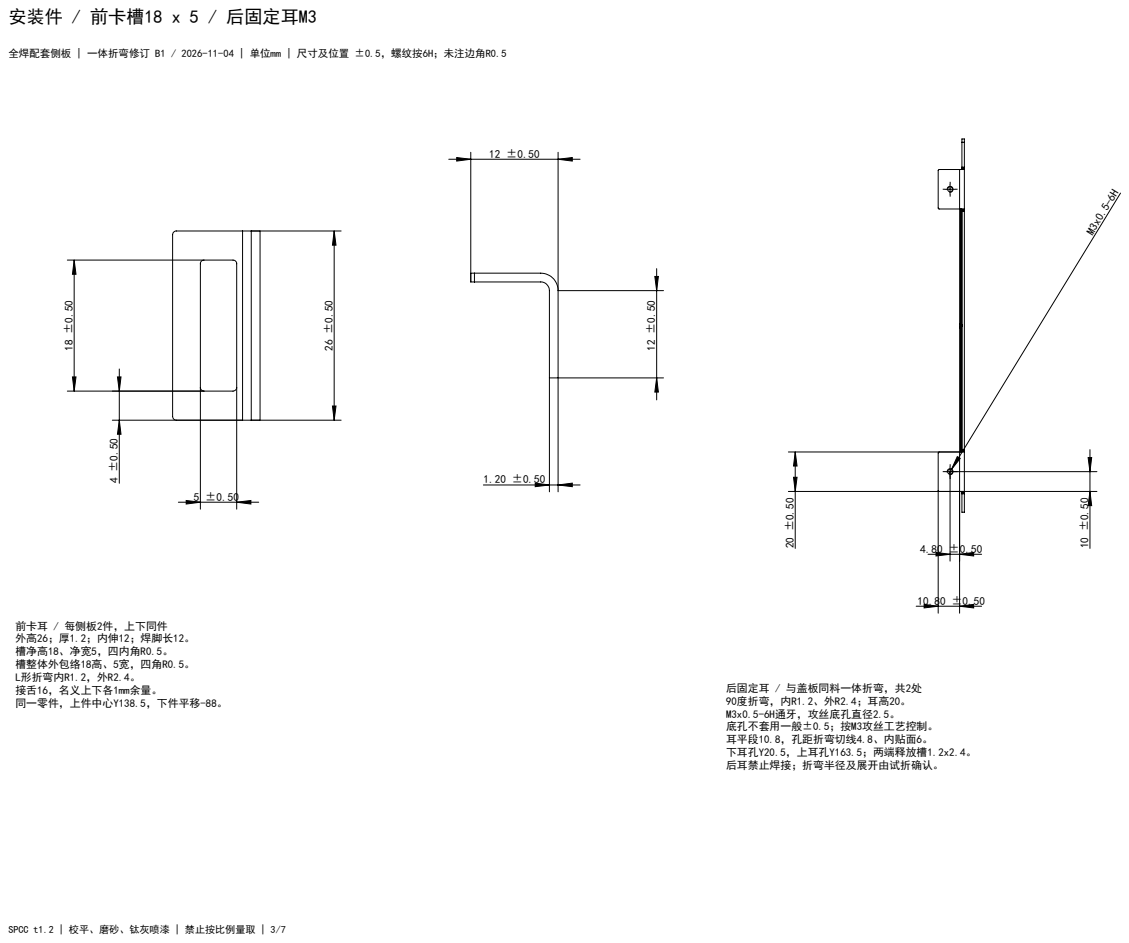
[picture p21: page 3]
安装件 / 前卡槽18 x 5 / 后固定耳M3; 前卡耳 / 每侧板2件，上下同件; 后固定耳 / 与盖板同料一体折弯，共2处

全焊配套侧板 | 一体折弯修订 B1 / 2026-11-04 | 单位mm | 尺寸及位置 ±0.5，螺纹按6H；未注边角R0.5

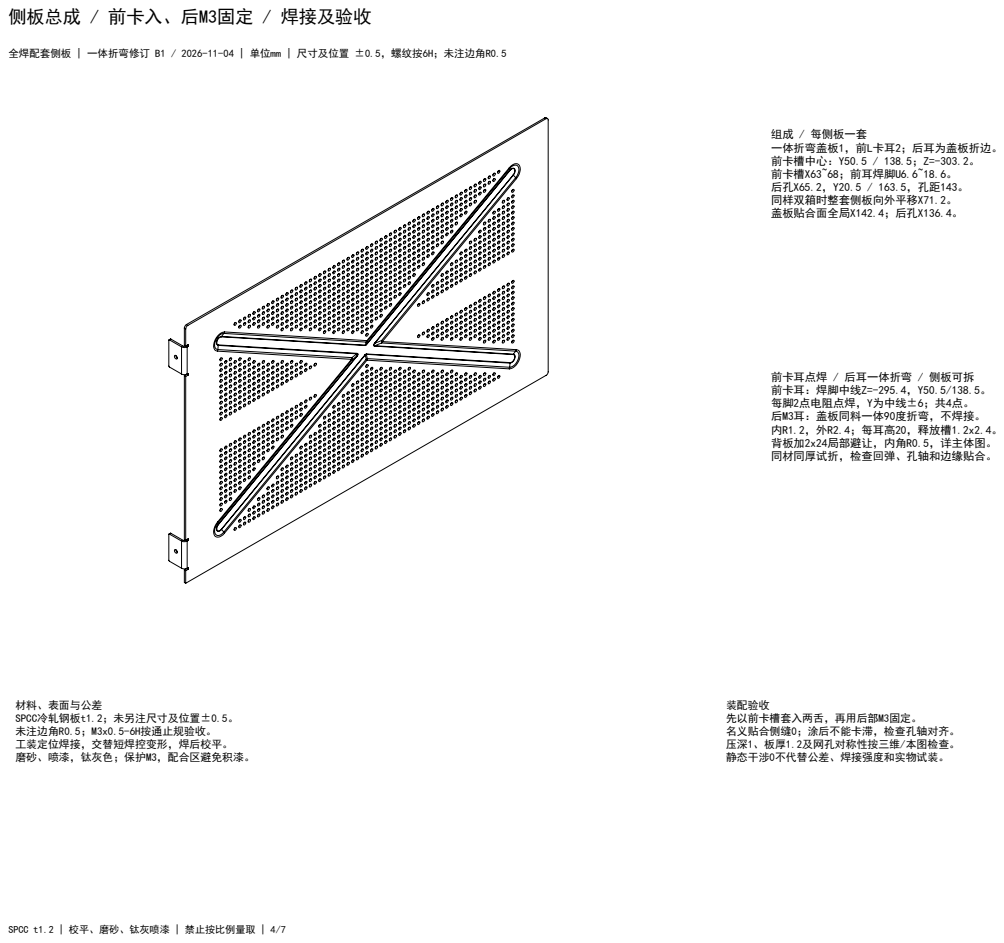
[picture p22: page 4]
组成 / 每侧板一套; 前卡槽中心：Y50.5 / 138.5；Z=-303.2。; 后孔X65.2，Y20.5 / 163.5，孔距143。

侧板总成 / 前卡入、后M3固定 / 焊接及验收

全焊配套侧板 | 一体折弯修订 B1 / 2026-11-04 | 单位mm | 尺寸及位置 ±0.5，螺纹按6H；未注边角R0.5

前卡耳点焊 / 后耳一体折弯 / 侧板可拆
前卡耳：焊脚中线Z=-295.4，Y50.5/138.5。
每脚2点电阻点焊，Y为中线±6；共4点。
后M3耳：盖板同料一体90度折弯，不焊接。
内R1.2，外R2.4；每耳高20，释放槽1.2x2.4。
背板加2x24局部避让，内角R0.5，详主体图。
同材同厚试折，检查回弹、孔轴和边缘贴合。

材料、表面与公差
SPCC冷轧钢板t1.2；未另注尺寸及位置±0.5。
未注边角R0.5；M3x0.5-6H按通止规验收。
工装定位焊接，交替短焊控变形，焊后校平。
磨砂、喷漆，钛灰色；保护M3，配合区避免积漆。

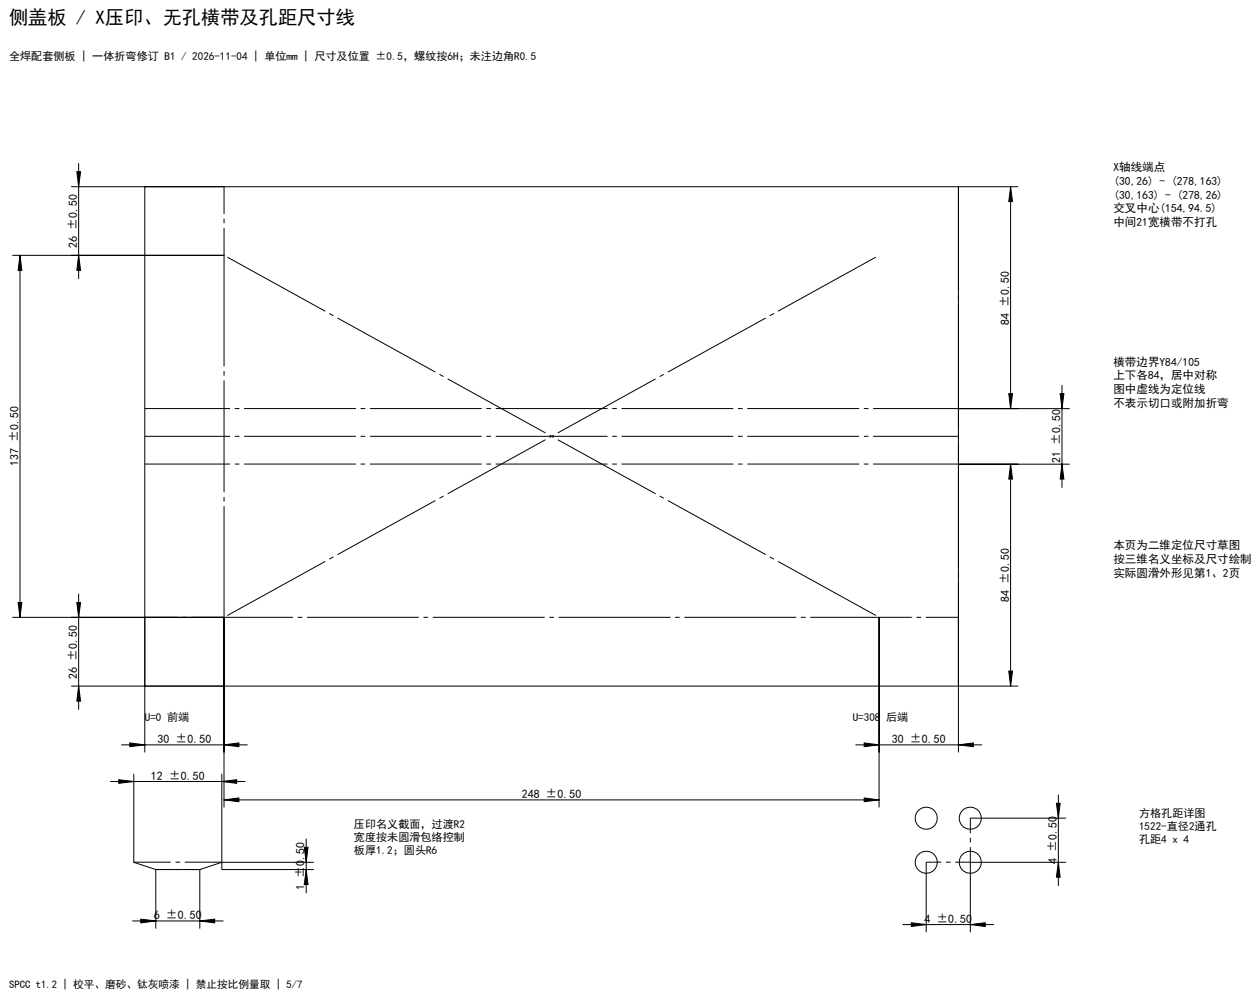
[picture p23: page 5]

侧盖板 / X压印、无孔横带及孔距尺寸线

全焊配套侧板 | 一体折弯修订 B1 / 2026-11-04 | 单位mm | 尺寸及位置 ±0.5，螺纹按6H；未注边角R0.5

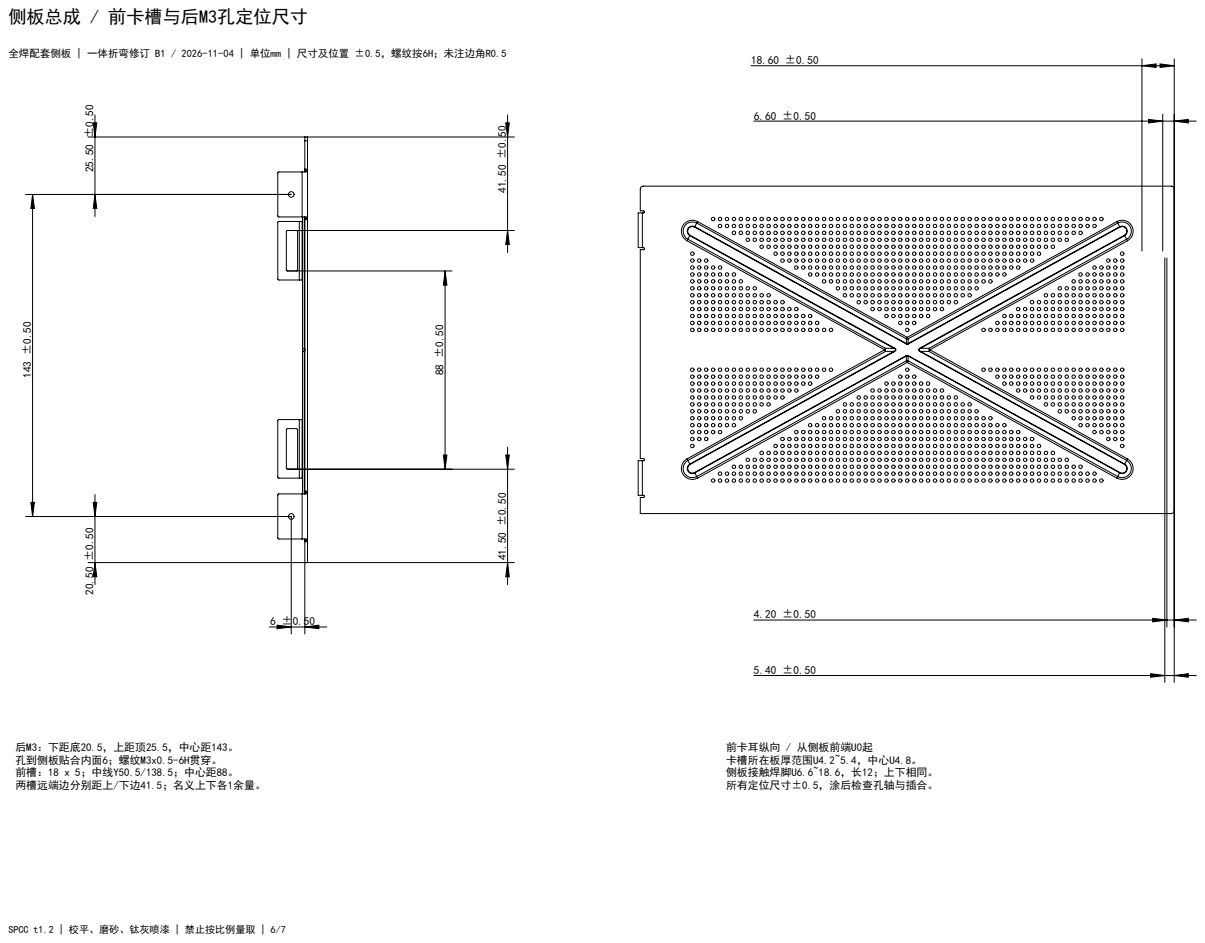
[picture p24: page 6]
侧板总成 / 前卡槽与后M3孔定位尺寸; 前槽：18 x 5；中线Y50.5/138.5；中心距88。; 前卡耳纵向 / 从侧板前端U0起

全焊配套侧板 | 一体折弯修订 B1 / 2026-11-04 | 单位mm | 尺寸及位置 ±0.5，螺纹按6H；未注边角R0.5

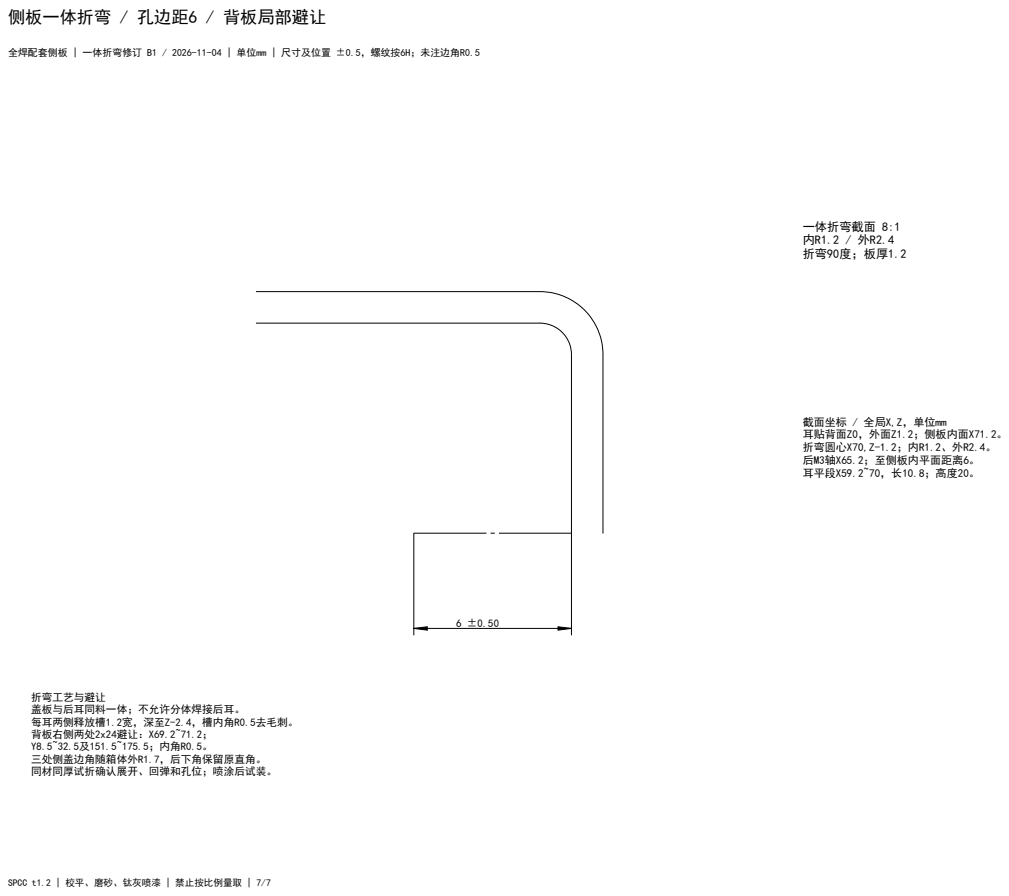
[picture p25: page 7]
侧板一体折弯 / 孔边距6 / 背板局部避让; 一体折弯截面 8:1 内R1.2 / 外R2.4; 截面坐标 / 全局X,Z，单位mm

全焊配套侧板 | 一体折弯修订 B1 / 2026-11-04 | 单位mm | 尺寸及位置 ±0.5，螺纹按6H；未注边角R0.5
