alphane-ai/welded-modular-chassis-cad/(commit log)

2026-11-07 Initialize chassis design archive
2026-11-07 Archive final welded chassis CAD and document design decisions
    [全焊_主体_草图可编辑.SLDPRT, 全焊_侧板_X压印深1_尺寸与制造要求.SLDDRW, 全焊_侧板总成_草图可编辑.SLDASM, 全焊_前插榫_舌16_R2_草图可编辑.SLDPRT, 全焊_单箱_草图可编辑.SLDASM, 全焊_单箱含侧板_草图可编辑.SLDASM, 全焊_后安装挡片_M3_草图可编辑.SLDPRT, 全焊_生产尺寸与制造要求.SLDDRW]
